afch/DDS-AD9912-Arduino-Shield/Firmware Source (.INO File)/HW v2.x/DDS-AD9912-Firmware_v2.x/main.cpp

/*                                        *******************************************
 *                                        *             GRA-AFCH.COM                *
 *                                        *******************************************                                      
 */

#include <Arduino.h>
#include "main.h"

/*Adafruit_SSD1306 display = Adafruit_SSD1306(128, 64, &Wire);
ClickButton modeButton(MODE_PIN, LOW, CLICKBTN_PULLUP);*/

void DisplaySaved(void)
{
  display.clearDisplay();
  display.setTextSize(2);
  display.setTextColor(WHITE);
  display.setCursor(40, 0);
  //display.setCursor(0, 0);
  display.cp437(true);
  display.println("SETUP");
  display.setCursor(40, 32);
  display.print("SAVED");
  display.display();
}

String PreZero(int Digit)
{
  if (Digit < 10) return "00" + String(Digit);
  if (Digit < 100) return "0" + String(Digit);
  return String(Digit);
}
