afch/DDS-AD9912-Arduino-Shield/(commit log)

2023-04-27 Drivers and Flasher added
    Drivers and Flasher added
2023-06-07 Sample program for PC
2023-06-20 v1.03
    Accelerated processing of commands transmitted via a serial port.
    Encoder performance has been improved.
2024-02-26 Drivers update
2025-10-06 v2.08
    Fixed: Improved FTW calculation accuracy
    [AD9912.cpp, AD9912.h, DDS-AD9912-Firmware_v2.x.ino]
